dronecz/esp32_camera_board/HW/rev.B/esp32_cam_rev_B.brd

## EAGLE design HW/rev.B/esp32_cam_rev_B.brd (2019-10-09)

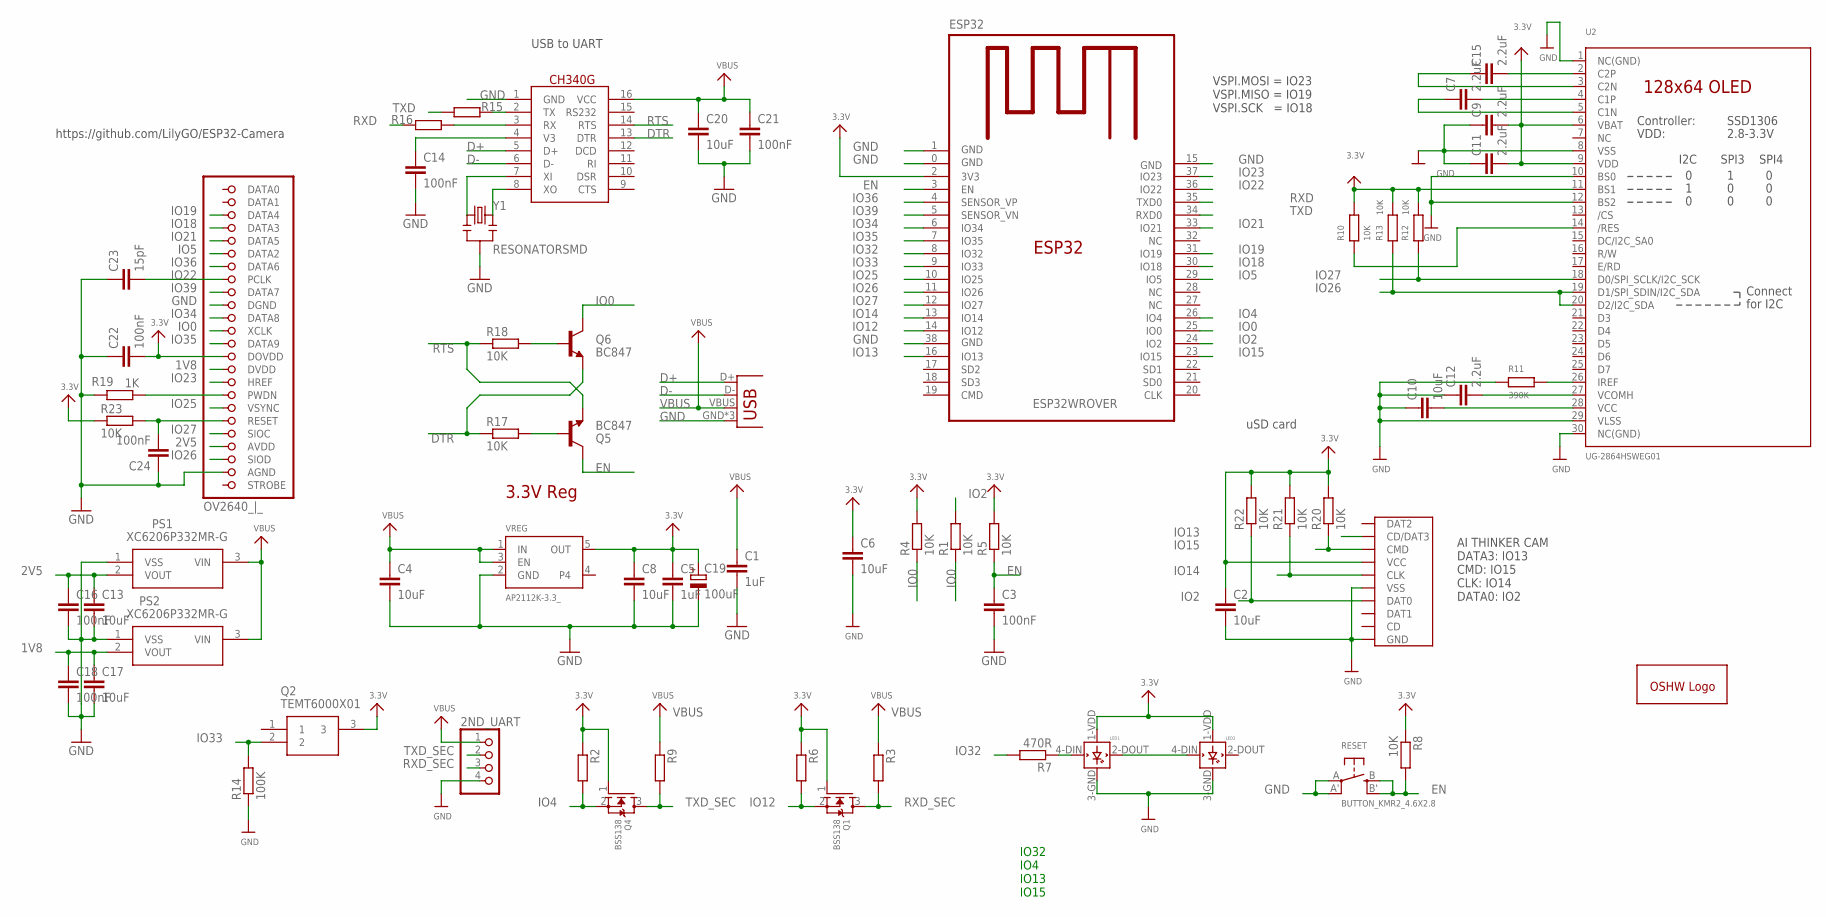
[picture p1: schematic esp32_cam_rev_B.sch]

Parts:
2ND_UART: JST_PH4; JSTPH4
C1: 1uF; C0805K
C2, C4, C8, C10, C13, C17, C20: 10uF; C0805
C3, C14: 100nF; C0805K
C5: 1uF; C0805
C6: 10uF; C0805K
C7, C9, C11, C12, C15: 2.2uF; C0805
C16, C18, C21, C22, C24: 100nF; C0805
C19: 100uF; CT6032
C23: 15pF; C0805
CH340G: CH340G; SO16
ESP32: ESP32WROVER
FPC_CONNECTOR: OV2640_|_; 5051102491
GOLD_ORB_SM1: OSHWLOGO_; OSHW_5MM_LOGO
LED1, LED2: WS2812B; WS2812B_5050
PS1, PS2: XC6206P332MR-G; SOT95P280X130-3N
Q1, Q4: BSS138; SOT95P240X110-3
Q2: TEMT6000X01
Q5, Q6: BC847; SOT23-3
R1, R2, R3, R4, R5, R6, R8, R9, R10, R12, R13, R17, R18, R20, R21, R22, R23: 10K; R0805
R7, R15, R16: 470R; R0805
R11: 390K; R0805
R14: 100K; R0805
R19: 1K; R0805
RESET: BUTTON_KMR2_4.6X2.8
SD_CARD: MICRO_SD_CARD_; TFP09-2--12B
U2: UG-2864HSWEG01; UG-2864HSWEG01_1.3_WRAPAROUND_MIRRORED
USB: USB_MICRO_ATTEND_; USB_MICRO
VREG: AP2112K-3.3_; SOT95P290X120-5
Y1: RESONATORSMD; RESONATOR-SMD

Connections:
1V8: C17.1, C18.1, FPC_CONNECTOR.15 (DVDD), PS2.2 (VOUT)
2V5: C13.1, C16.1, FPC_CONNECTOR.21 (AVDD), PS1.2 (VOUT)
3.3V: C2.1, C5.1, C6.1, C8.1, C9.2, C11.2, C19.+, C22.2, ESP32.2 (3V3), FPC_CONNECTOR.14 (DOVDD), LED1.1-VDD (VDD), LED2.1-VDD (VDD), Q1.1 (G), Q2.3, Q4.1 (G), R2.1, R4.2, R5.2, R6.1, R8.1, R10.2, R12.2, R13.2, R20.2, R21.2, R22.2, R23.1, SD_CARD.VCC, U2.6 (VBAT), U2.9 (VDD), U2.11 (BS1), VREG.5 (OUT)
D+: CH340G.5 (D+), USB.D+
D-: CH340G.6 (D-), USB.D-
DTR: CH340G.13 (DTR), Q6.2 (E), R17.1
EN: C3.1, ESP32.3 (EN), Q5.3 (C), R5.1, R8.2, RESET.B (S), RESET.B' (S1)
GND: 2ND_UART.4, C1.2, C2.2, C3.2, C4.2, C5.2, C6.2, C8.2, C9.1, C10.1, C11.1, C12.1, C13.2, C14.2, C16.2, C17.2, C18.2, C19.-, C20.2, C21.2, C22.1, C23.1, C24.1, CH340G.1 (GND), ESP32.0 (GND), ESP32.1 (GND), ESP32.15 (GND), ESP32.38 (GND), FPC_CONNECTOR.10 (DGND), FPC_CONNECTOR.23 (AGND), LED1.3-GND (GND), LED2.3-GND (GND), PS1.1 (VSS), PS2.1 (VSS), R11.1, R14.1, R19.2, RESET.A, RESET.A' (P1), SD_CARD.GND, SD_CARD.GND@1 (GND), SD_CARD.GND@2 (GND), SD_CARD.GND@3 (VSS), SD_CARD.VSS (GND), U2.1 (NC(GND)), U2.8 (VSS), U2.10 (BS0), U2.12 (BS2), U2.29 (VLSS), U2.30 (NC(GND)), USB.GND, USB.GND@2 (GND), USB.GND@3 (GND), VREG.2 (GND), Y1.2
IO0: ESP32.25 (IO0), FPC_CONNECTOR.12 (XCLK), Q6.3 (C), R1.1, R4.1
IO2: ESP32.24 (IO2), R1.2, R22.1, SD_CARD.DAT0
IO4: ESP32.26 (IO4), Q4.2 (S), R2.2
IO5: ESP32.29 (IO5), FPC_CONNECTOR.6 (DATA2)
IO12: ESP32.14 (IO12), Q1.2 (S), R6.2
IO13: ESP32.16 (IO13), SD_CARD.CD/DAT3
IO14: ESP32.13 (IO14), R21.1, SD_CARD.CLK
IO15: ESP32.23 (IO15), R20.1, SD_CARD.CMD
IO18: ESP32.30 (IO18), FPC_CONNECTOR.4 (DATA3)
IO19: ESP32.31 (IO19), FPC_CONNECTOR.3 (DATA4)
IO21: ESP32.33 (IO21), FPC_CONNECTOR.5 (DATA5)
IO22: C23.2, ESP32.36 (IO22), FPC_CONNECTOR.8 (PCLK)
IO23: ESP32.37 (IO23), FPC_CONNECTOR.16 (HREF)
IO25: ESP32.10 (IO25), FPC_CONNECTOR.18 (VSYNC)
IO26: ESP32.11 (IO26), FPC_CONNECTOR.22 (SIOD), R13.1, U2.19 (D1/SPI_SDIN/I2C_SDA), U2.20 (D2/I2C_SDA)
IO27: ESP32.12 (IO27), FPC_CONNECTOR.20 (SIOC), R12.1, U2.18 (D0/SPI_SCLK/I2C_SCK)
IO32: ESP32.8 (IO32), R7.2
IO33: ESP32.9 (IO33), Q2.2, R14.2
IO34: ESP32.6 (IO34), FPC_CONNECTOR.11 (DATA8)
IO35: ESP32.7 (IO35), FPC_CONNECTOR.13 (DATA9)
IO36: ESP32.4 (SENSOR_VP), FPC_CONNECTOR.7 (DATA6)
IO39: ESP32.5 (SENSOR_VN), FPC_CONNECTOR.9 (DATA7)
unnamed: R10.1, U2.14 (/RES)
unnamed: LED1.4-DIN (DIN), R7.1
unnamed: LED1.2-DOUT (DOUT), LED2.4-DIN (DIN)
unnamed: R11.2, U2.26 (IREF)
unnamed: C15.2, U2.2 (C2P)
unnamed: CH340G.8 (XO), Y1.3
unnamed: C15.1, U2.3 (C2N)
unnamed: C7.2, U2.4 (C1P)
unnamed: C7.1, U2.5 (C1N)
unnamed: C10.2, U2.28 (VCC)
unnamed: C12.2, U2.27 (VCOMH)
unnamed: CH340G.7 (XI), Y1.1
unnamed: C14.1, CH340G.4 (V3)
unnamed: CH340G.2 (TX), R15.1
unnamed: CH340G.3 (RX), R16.1
unnamed: Q5.1 (B), R17.2
unnamed: Q6.1 (B), R18.2
unnamed: FPC_CONNECTOR.17 (PWDN), R19.1
unnamed: C24.2, FPC_CONNECTOR.19 (RESET), R23.2
RTS: CH340G.14 (RTS), Q5.2 (E), R18.1
RXD: ESP32.35 (TXD0), R16.2
RXD_SEC: 2ND_UART.3, Q1.3 (D), R3.2
TXD: ESP32.34 (RXD0), R15.2
TXD_SEC: 2ND_UART.2, Q4.3 (D), R9.2
VBUS: 2ND_UART.1, C1.1, C4.1, C20.1, C21.1, CH340G.16 (VCC), PS1.3 (VIN), PS2.3 (VIN), R3.1, R9.1, USB.VBUS, VREG.1 (IN), VREG.3 (EN)

Notes on the sheet:
USB to UART
VSPI.MOSI = IO23 VSPI.MISO = IO19 VSPI.SCK = IO18
3.3V Reg
uSD card
https://github.com/LilyGO/ESP32-Camera
AI THINKER CAM DATA3: IO13 CMD: IO15 CLK: IO14 DATA0: IO2
IO32 IO4 IO13 IO15

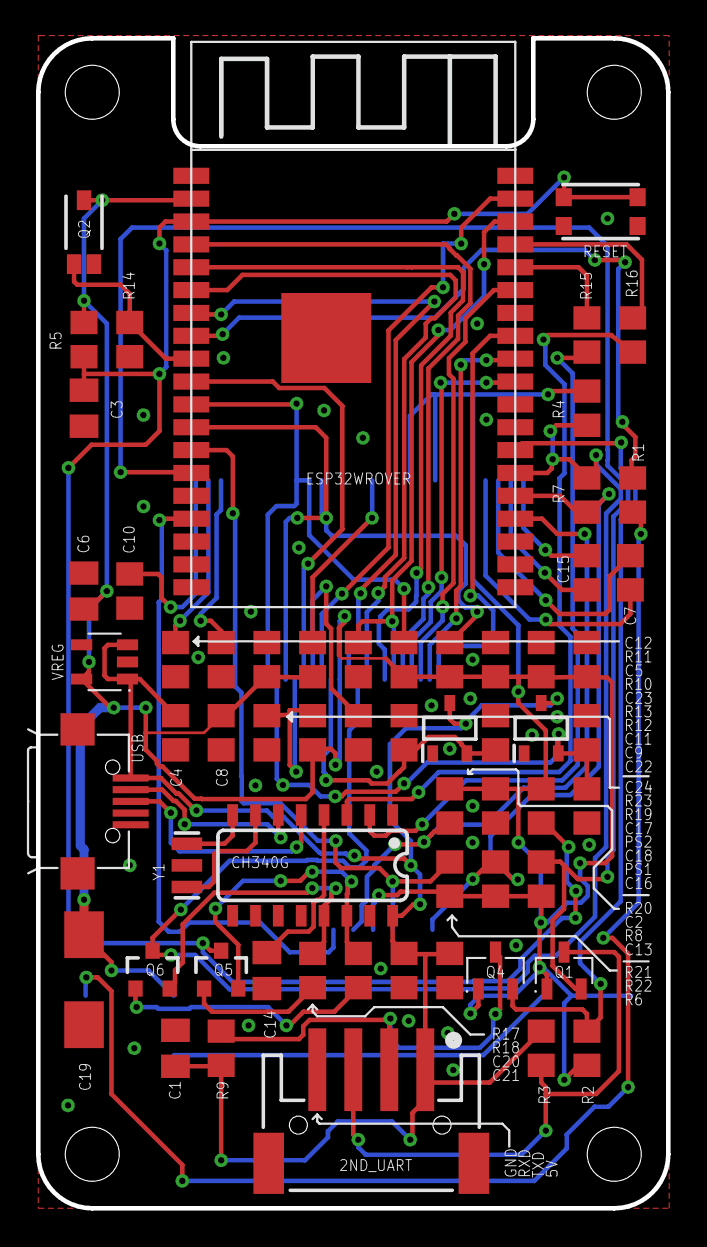
[picture p2: board esp32_cam_rev_B.brd from above]

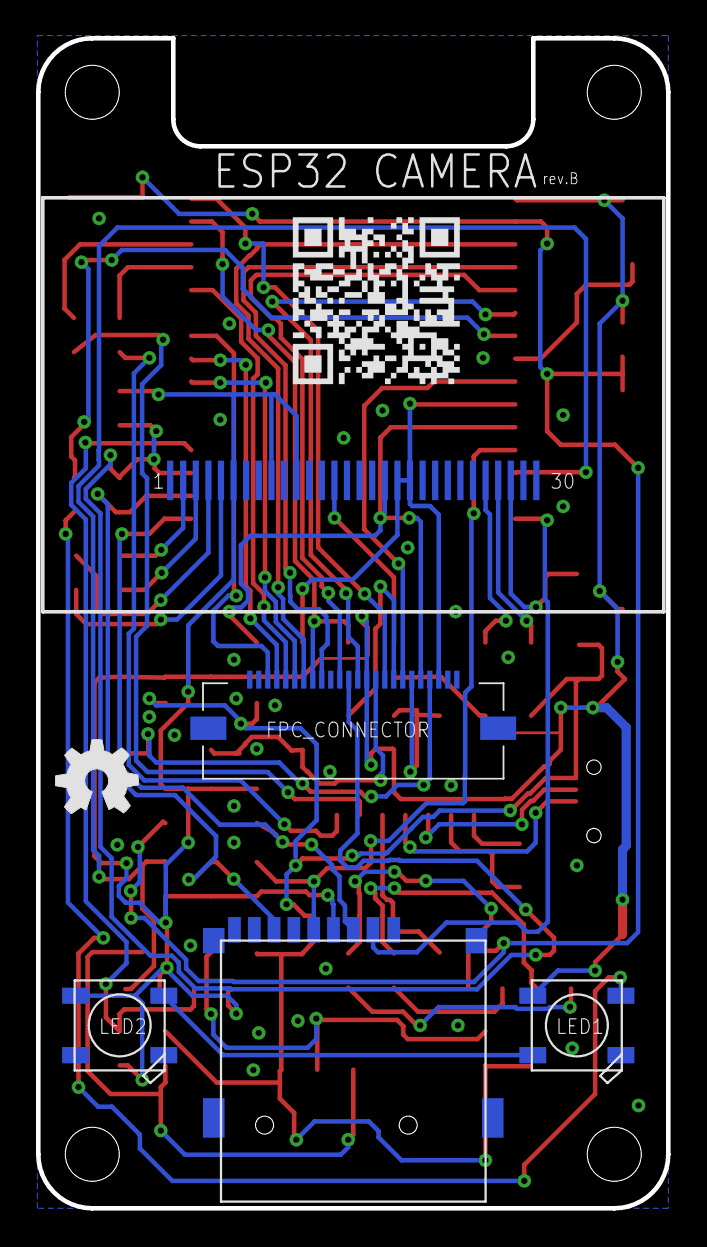
[picture p3: board esp32_cam_rev_B.brd from below]

Board: 2 copper layers, 35.0 x 65.0 mm, 67 parts (5 on the bottom side), 55 nets.
