dronecz/esp32_camera_board/HW/rev.A/esp32_cam_rev_A.brd

## EAGLE design HW/rev.A/esp32_cam_rev_A.brd (2019-10-09, an earlier design)

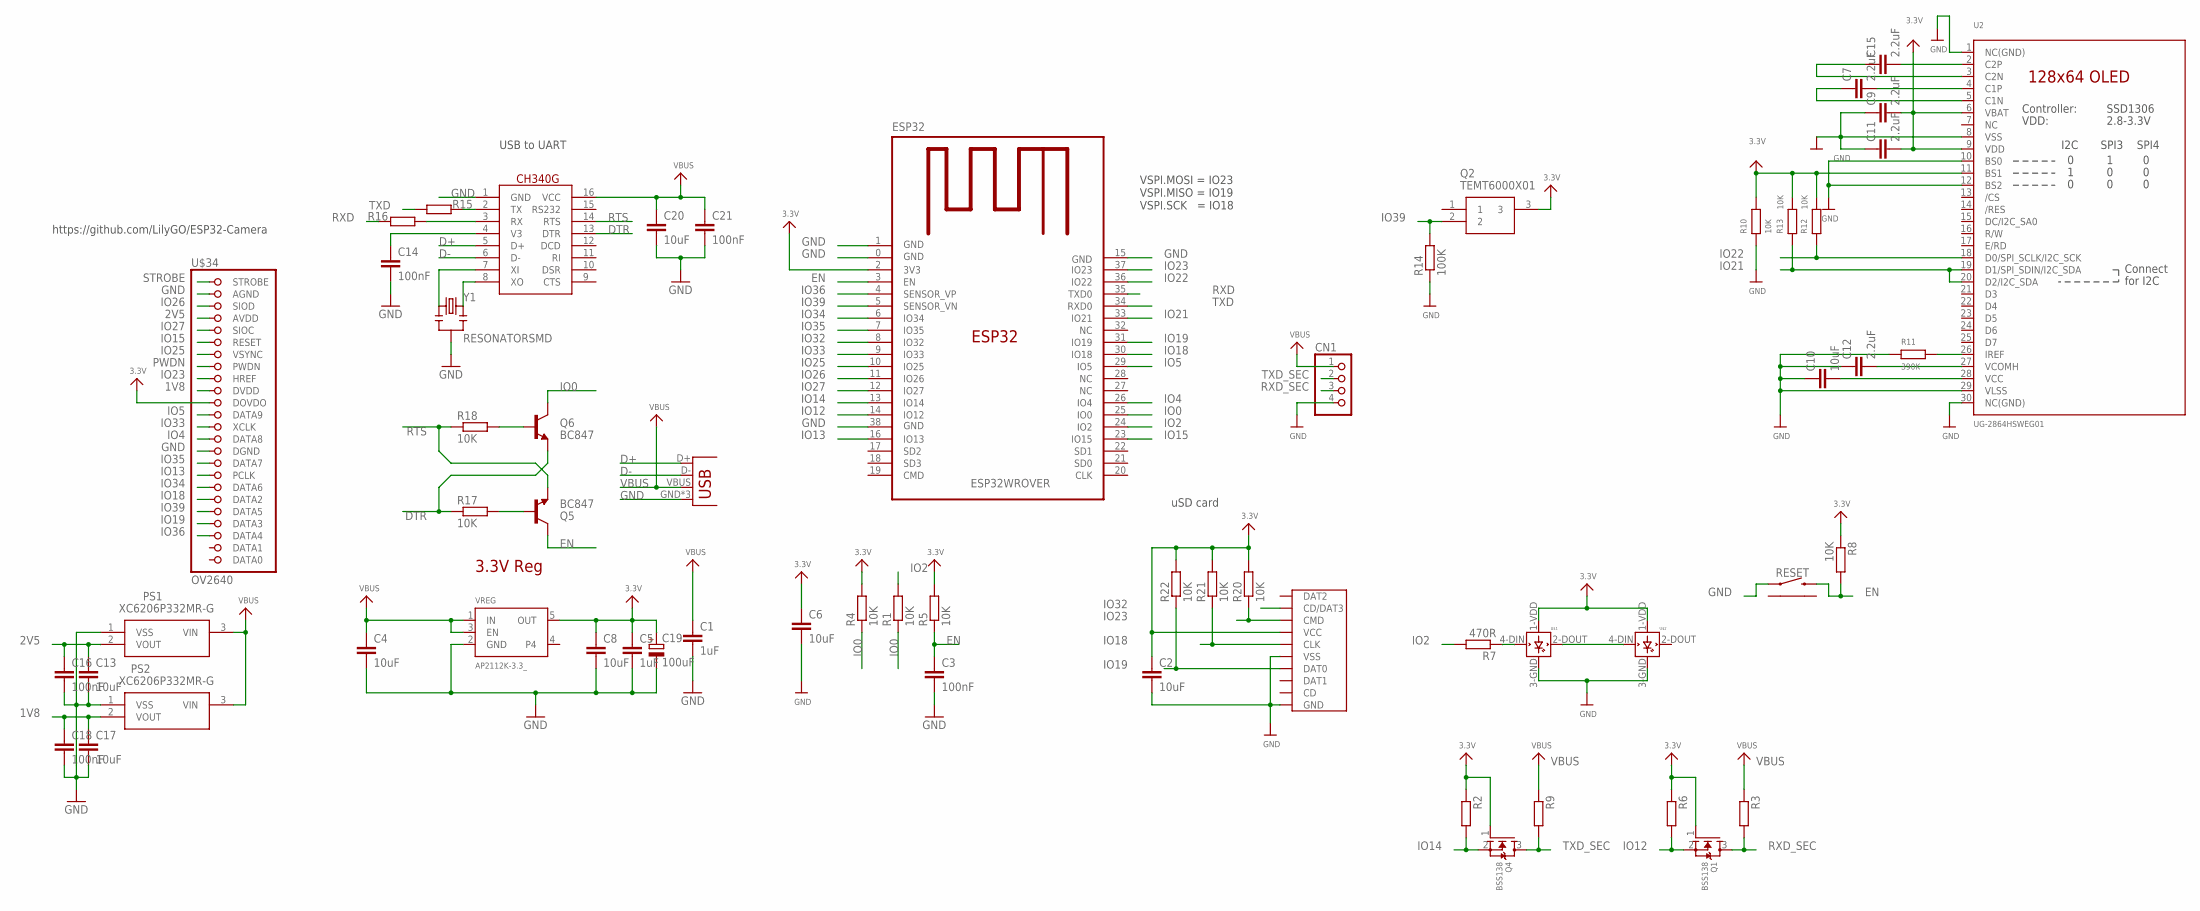
[picture p4: schematic esp32_cam_rev_A.sch]

Parts:
C1, C5: 1uF; C0805K
C2, C4, C6, C8, C13, C17, C20: 10uF; C0805K
C3, C14, C16, C18, C21: 100nF; C0805K
C7, C9, C11, C12, C15: 2.2uF; C0805
C10: 10uF; C0805
C19: 100uF; CT6032
CN1: JST_PH4; JSTPH4
ESP32: ESP32WROVER
PS1, PS2: XC6206P332MR-G; SOT95P280X130-3N
Q1, Q4: BSS138; SOT95P240X110-3
Q2: TEMT6000X01
Q5, Q6: BC847; SOT23-3
R1, R2, R3, R4, R5, R6, R8, R9, R10, R12, R13, R17, R18, R20, R21, R22: 10K; R0805
R7, R15, R16: 470R; R0805
R11: 390K; R0805
R14: 100K; R0805
RESET: TACTILE_SWITCH_RIGHT_ANGLE_THT"; TACTILE_SWITCH_RIGHT_ANGLE_THT
SD_CARD: MICRO_SD_CARD"; TFP09-2--12B
U2: UG-2864HSWEG01; UG-2864HSWEG01_1.3_WRAPAROUND_MIRRORED
U$1, U$2: WS2812B; WS2812B_5050
U$23: CH340G; SO16
U$34: OV2640; FH12-24S-0.5SH
USB: USB_MICRO_ATTEND_; USB_MICRO
VREG: AP2112K-3.3_; SOT95P290X120-5
Y1: RESONATORSMD; RESONATOR-SMD

Connections:
1V8: C17.1, C18.1, PS2.2 (VOUT), U$34.10 (DVDD)
2V5: C13.1, C16.1, PS1.2 (VOUT), U$34.4 (AVDD)
3.3V: C2.1, C5.1, C6.1, C8.1, C9.2, C11.2, C19.+, ESP32.2 (3V3), Q1.1 (G), Q2.3, Q4.1 (G), R2.1, R4.2, R5.2, R6.1, R8.1, R10.2, R12.2, R13.2, R20.2, R21.2, R22.2, SD_CARD.VCC, U2.6 (VBAT), U2.9 (VDD), U2.11 (BS1), U$1.1-VDD (VDD), U$2.1-VDD (VDD), U$34.11 (DOVDO), VREG.5 (OUT)
D+: U$23.5 (D+), USB.D+
D-: U$23.6 (D-), USB.D-
DTR: Q6.2 (E), R17.1, U$23.13 (DTR)
EN: C3.1, ESP32.3 (EN), Q5.3 (C), R5.1, R8.2, RESET.2
GND: C1.2, C2.2, C3.2, C4.2, C5.2, C6.2, C8.2, C9.1, C10.1, C11.1, C12.1, C13.2, C14.2, C16.2, C17.2, C18.2, C19.-, C20.2, C21.2, CN1.4, ESP32.0 (GND), ESP32.1 (GND), ESP32.15 (GND), ESP32.38 (GND), PS1.1 (VSS), PS2.1 (VSS), R10.1, R11.1, R14.1, RESET.1, SD_CARD.GND, SD_CARD.GND@1 (GND), SD_CARD.GND@2 (GND), SD_CARD.GND@3 (VSS), SD_CARD.VSS (GND), U2.1 (NC(GND)), U2.8 (VSS), U2.10 (BS0), U2.12 (BS2), U2.29 (VLSS), U2.30 (NC(GND)), U$1.3-GND (GND), U$2.3-GND (GND), U$23.1 (GND), U$34.2 (AGND), U$34.15 (DGND), USB.GND, USB.GND@2 (GND), USB.GND@3 (GND), VREG.2 (GND), Y1.2
IO0: ESP32.25 (IO0), Q6.3 (C), R1.1, R4.1
IO2: ESP32.24 (IO2), R1.2, R7.2
IO4: ESP32.26 (IO4), U$34.14 (DATA8)
IO5: ESP32.29 (IO5), U$34.12 (DATA9)
IO12: ESP32.14 (IO12), Q1.2 (S), R6.2
IO13: ESP32.16 (IO13), U$34.17 (PCLK)
IO14: ESP32.13 (IO14), Q4.2 (S), R2.2
IO15: ESP32.23 (IO15), U$34.6 (RESET)
IO18: ESP32.30 (IO18), R21.1, SD_CARD.CLK, U$34.19 (DATA2)
IO19: ESP32.31 (IO19), R22.1, SD_CARD.DAT0, U$34.21 (DATA3)
IO21: ESP32.33 (IO21), R13.1, U2.19 (D1/SPI_SDIN/I2C_SDA), U2.20 (D2/I2C_SDA)
IO22: ESP32.36 (IO22), R12.1, U2.18 (D0/SPI_SCLK/I2C_SCK)
IO23: ESP32.37 (IO23), R20.1, SD_CARD.CMD, U$34.9 (HREF)
IO25: ESP32.10 (IO25), U$34.7 (VSYNC)
IO26: ESP32.11 (IO26), U$34.3 (SIOD)
IO27: ESP32.12 (IO27), U$34.5 (SIOC)
IO32: ESP32.8 (IO32), SD_CARD.CD/DAT3
IO33: ESP32.9 (IO33), U$34.13 (XCLK)
IO34: ESP32.6 (IO34), U$34.18 (DATA6)
IO35: ESP32.7 (IO35), U$34.16 (DATA7)
IO36: ESP32.4 (SENSOR_VP), U$34.22 (DATA4)
IO39: ESP32.5 (SENSOR_VN), Q2.2, R14.2, U$34.20 (DATA5)
unnamed: R7.1, U$1.4-DIN (DIN)
unnamed: U$1.2-DOUT (DOUT), U$2.4-DIN (DIN)
unnamed: R11.2, U2.26 (IREF)
unnamed: C15.2, U2.2 (C2P)
unnamed: U$23.8 (XO), Y1.3
unnamed: C15.1, U2.3 (C2N)
unnamed: C7.2, U2.4 (C1P)
unnamed: C7.1, U2.5 (C1N)
unnamed: C10.2, U2.28 (VCC)
unnamed: C12.2, U2.27 (VCOMH)
unnamed: U$23.7 (XI), Y1.1
unnamed: C14.1, U$23.4 (V3)
unnamed: R15.1, U$23.2 (TX)
unnamed: R16.1, U$23.3 (RX)
unnamed: Q5.1 (B), R17.2
unnamed: Q6.1 (B), R18.2
PWDN: U$34.8 (PWDN)
RTS: Q5.2 (E), R18.1, U$23.14 (RTS)
RXD: ESP32.35 (TXD0), R16.2
RXD_SEC: CN1.3, Q1.3 (D), R3.2
STROBE: U$34.1 (STROBE)
TXD: ESP32.34 (RXD0), R15.2
TXD_SEC: CN1.2, Q4.3 (D), R9.2
VBUS: C1.1, C4.1, C20.1, C21.1, CN1.1, PS1.3 (VIN), PS2.3 (VIN), R3.1, R9.1, U$23.16 (VCC), USB.VBUS, VREG.1 (IN), VREG.3 (EN)

Notes on the sheet:
USB to UART
VSPI.MOSI = IO23 VSPI.MISO = IO19 VSPI.SCK = IO18
3.3V Reg
uSD card
https://github.com/LilyGO/ESP32-Camera

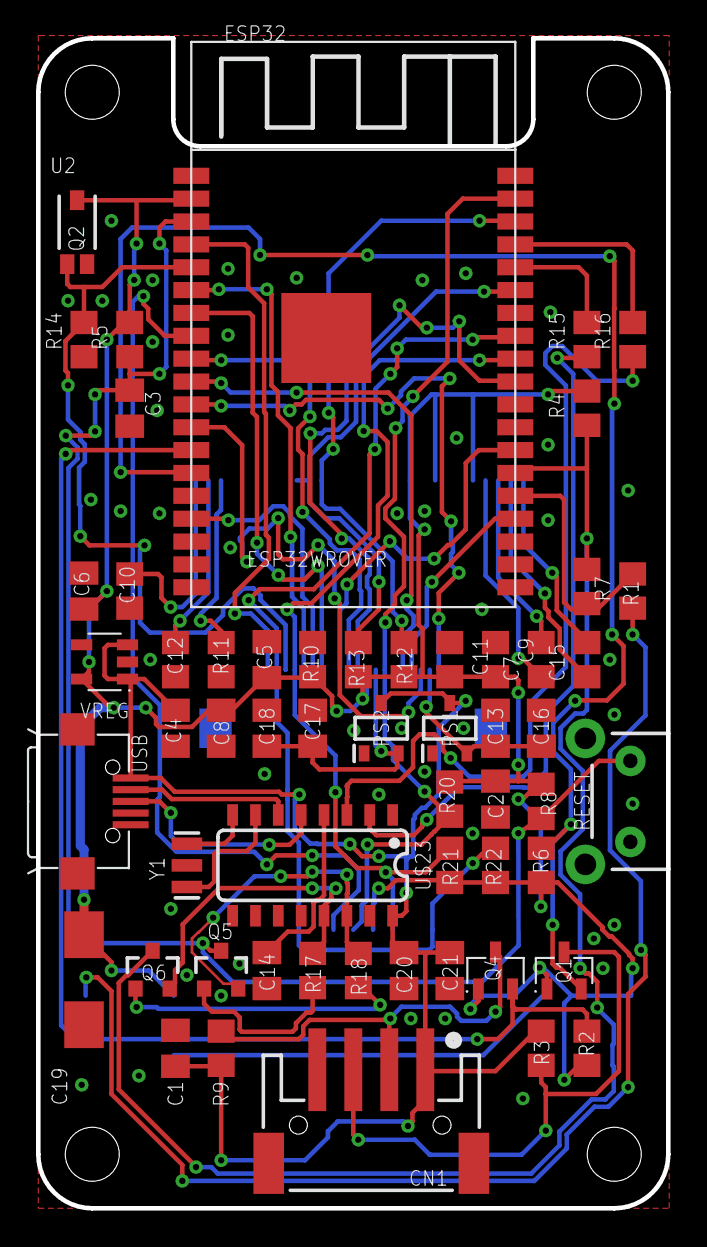
[picture p5: board esp32_cam_rev_A.brd from above]

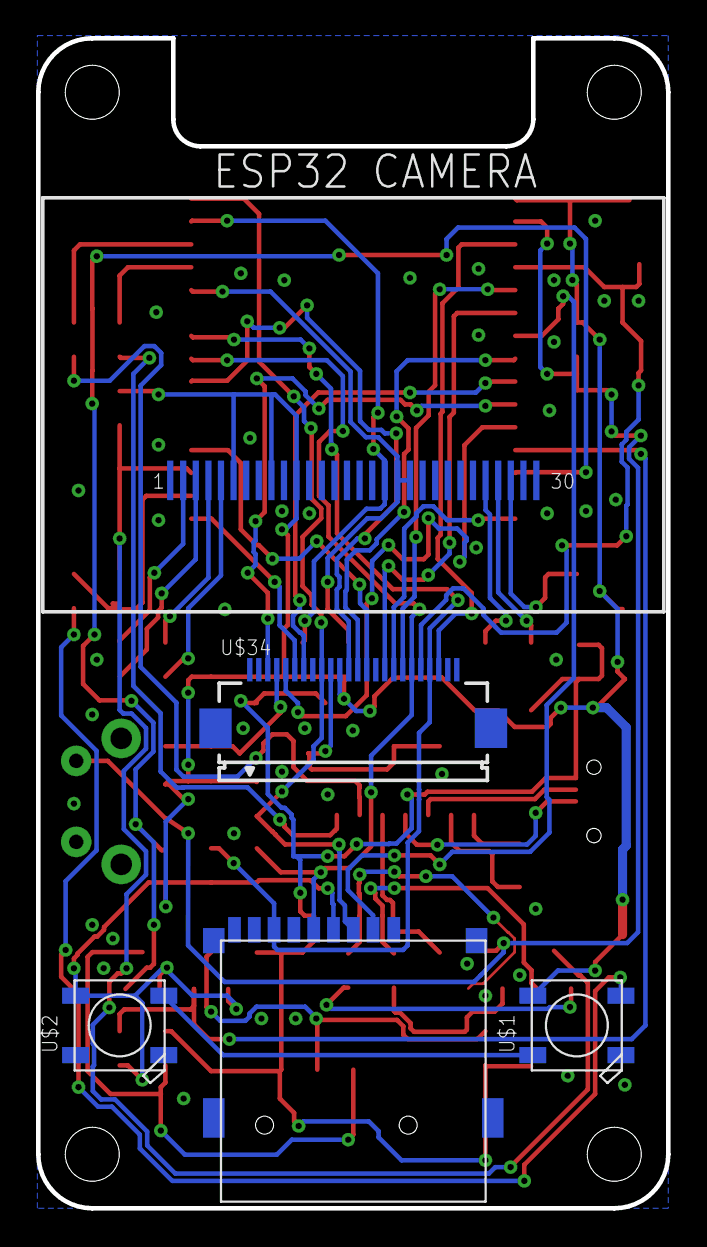
[picture p6: board esp32_cam_rev_A.brd from below]

Board: 2 copper layers, 35.0 x 65.0 mm, 61 parts (4 on the bottom side), 52 nets.
